thunderbikes/STM-32-Relay-Circuit/Schematic.pdf

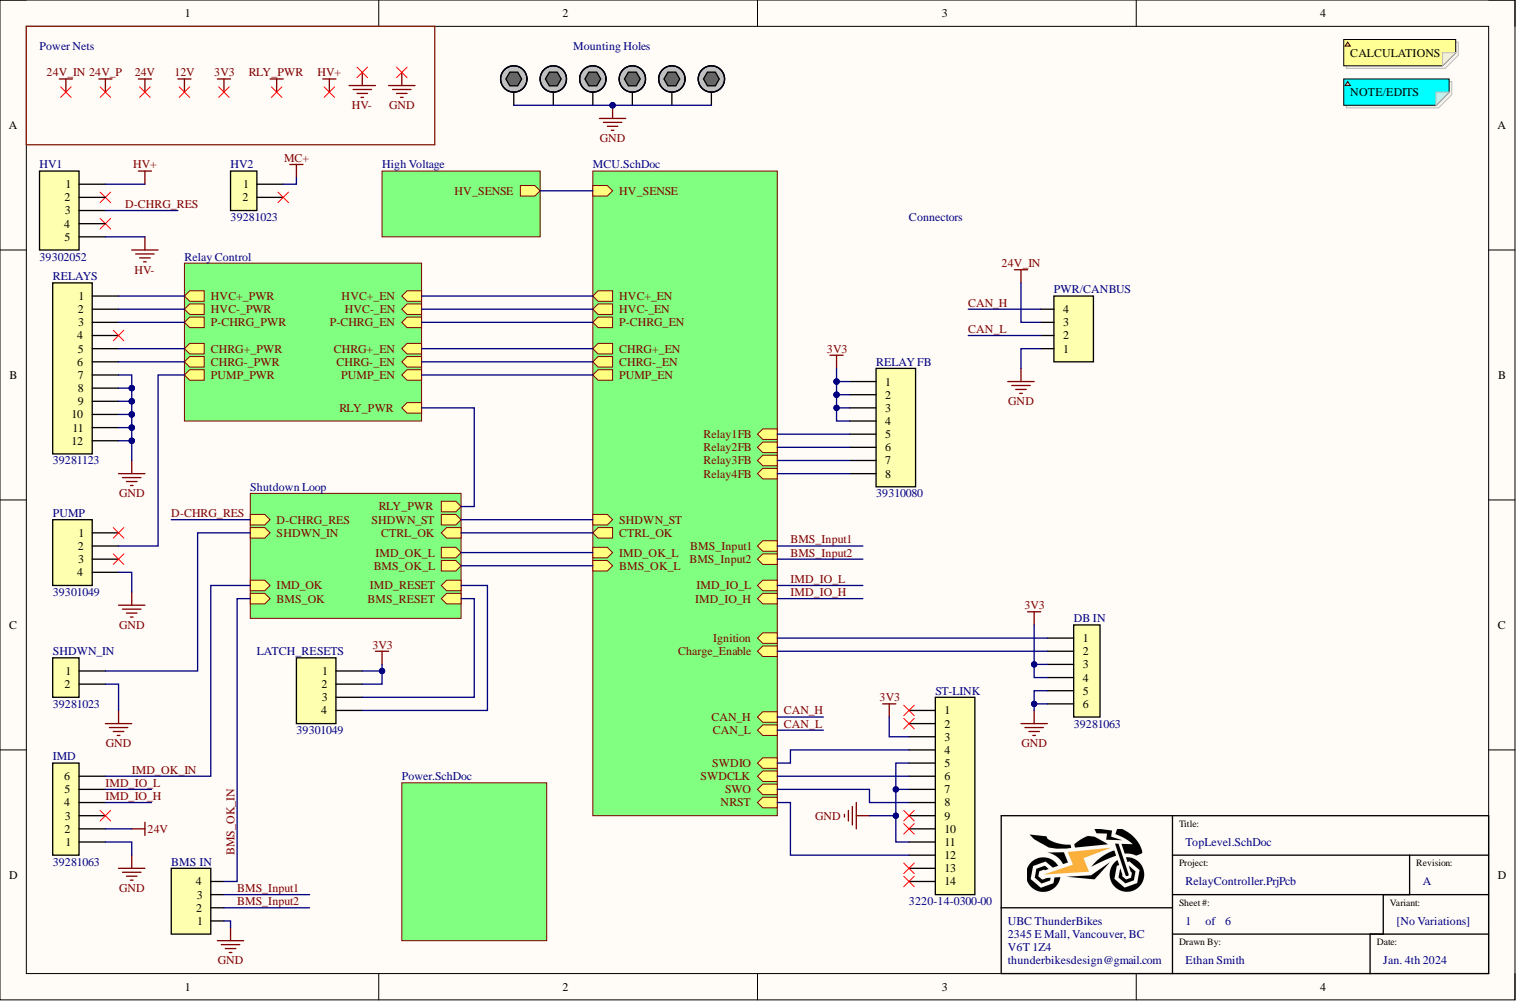
[picture p1: page 1]
Power Nets; Mounting Holes; RELAY FB; Shutdown Loop; High Voltage; Relay Control; BMS IN

IMD_OK_IN
IMD_IO_L IMD_IO_H

Title: TopLevel.SchDoc

Project: RelayController.PrjPcb | Revision: A

Sheet #: of 6 | Variant: [No Variations]

UBC ThunderBikes
2345 E Mall, Vancouver, BC
thunderbikesdesign@gmail.com

Drawn By: Ethan Smith | Date: Jan. 4th 2024

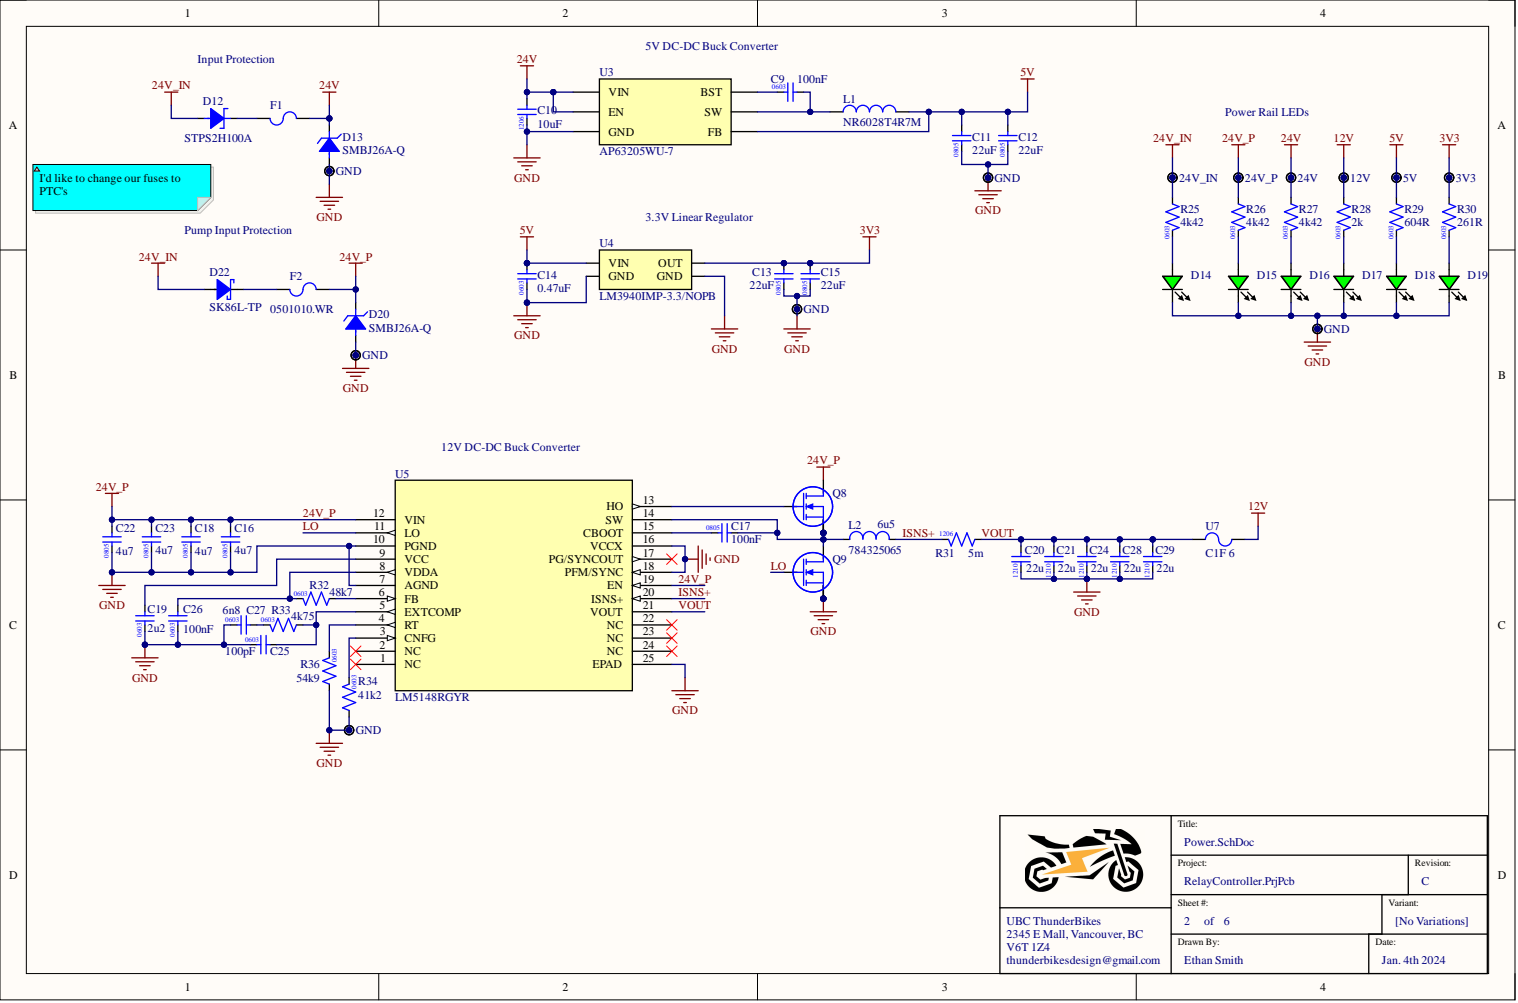
[picture p2: page 2]

5V DC-DC Buck Converter

I'd like to change our fuses to
PTC's

12V DC-DC Buck Converter

Title: Power.SchDoc

Project: RelayController.PrjPcb | Revision: C

Sheet #: | Variant:

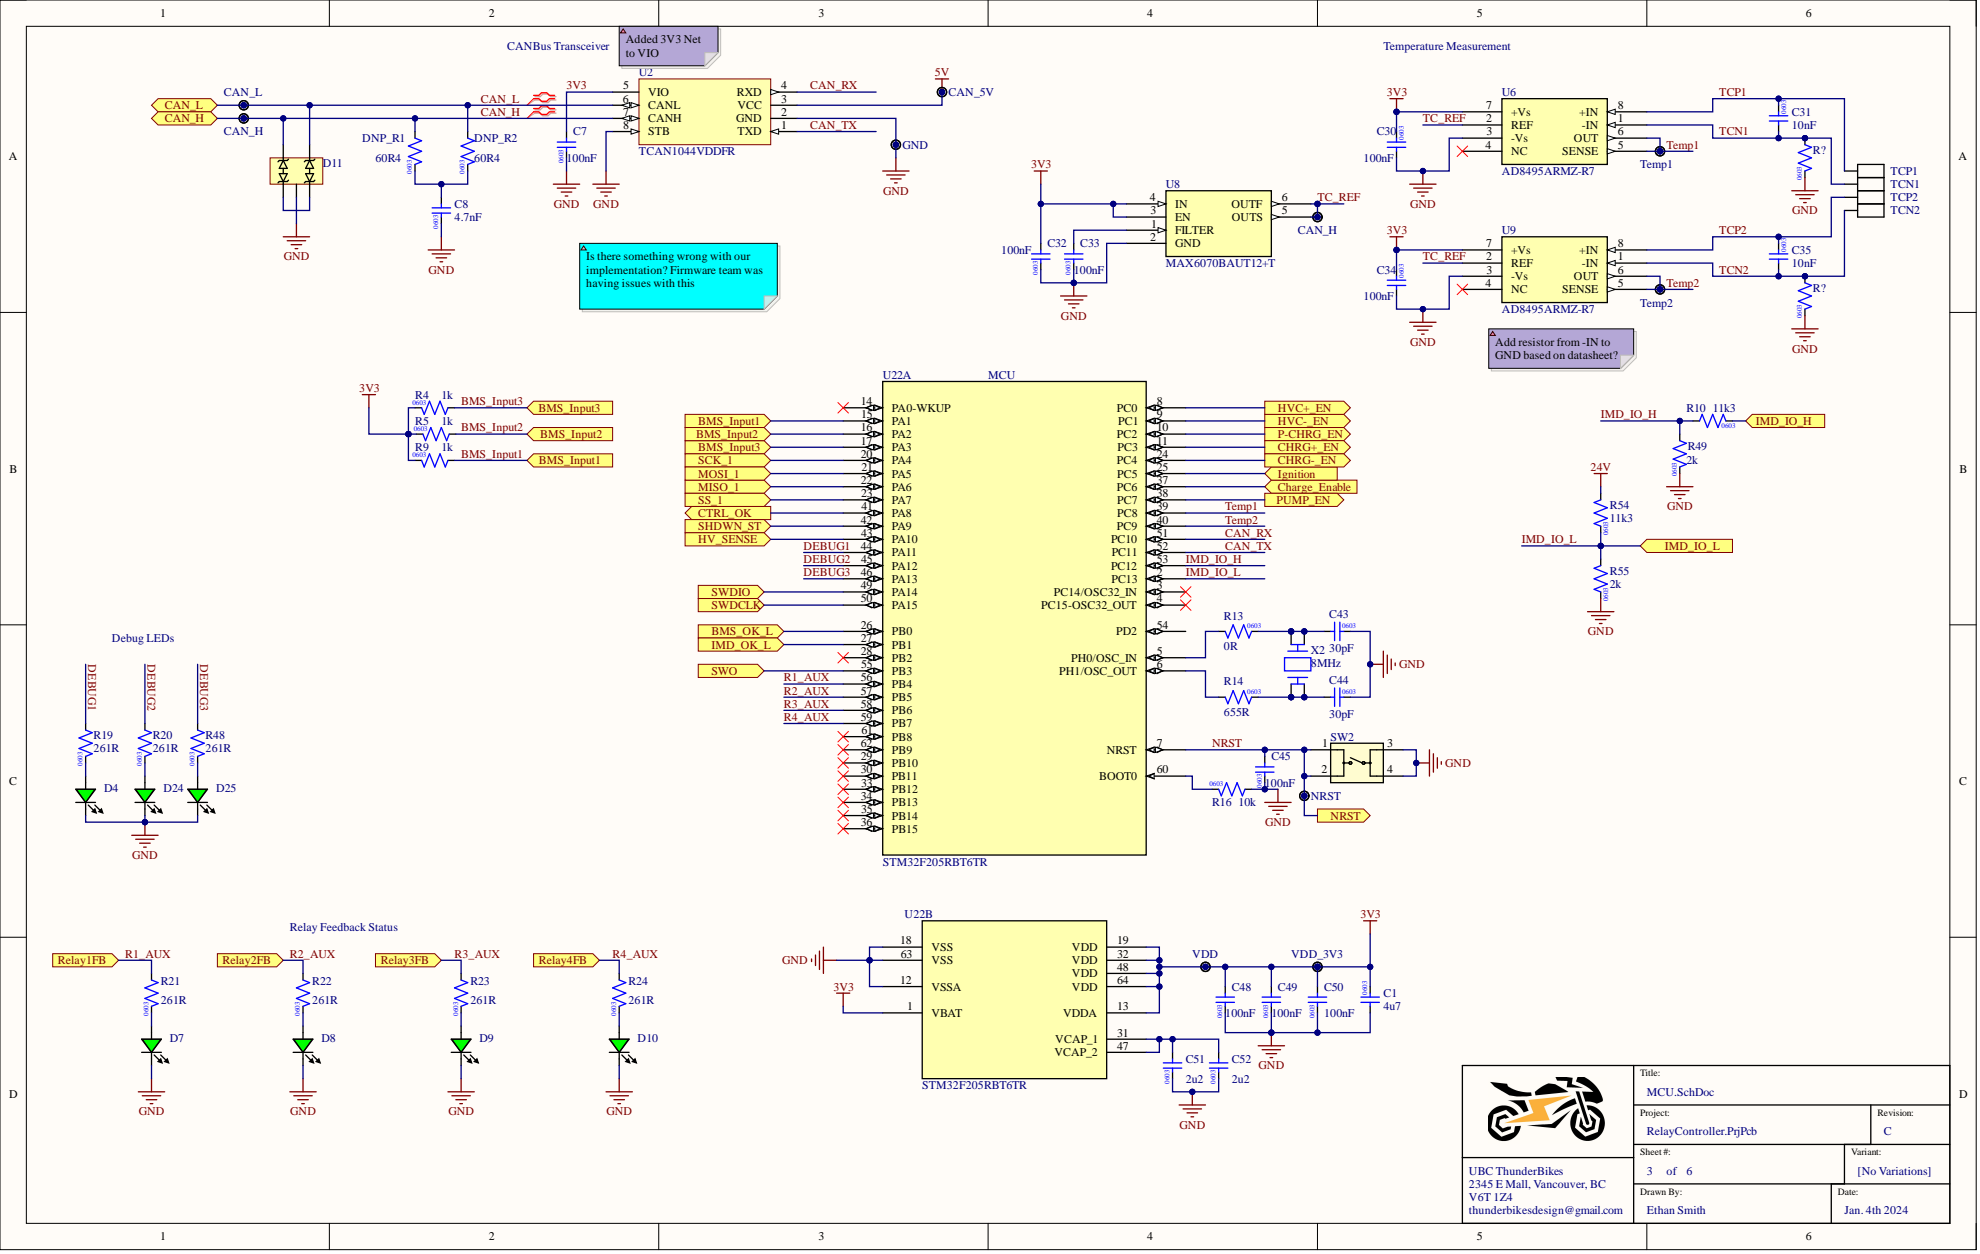
[picture p3: page 3]

-IN SENSE | 1 REF 2 | C31
-Vs 3 NC 4 | 5 OUT 6 | TCN1

CAN_TX

Temp1 | R?

Isthere something wrong with our
implementation? Firmware team was
having issues with this

-IN SENSE | 1 REF 2 | C35
-Vs 3 NC 4 | 5 OUT 6 | TCN2

Add resistor from -IN to
GND based on datasheet?

VBAT 1 | C1 3V3

Title: MCU.SchDoc

Project: RelayController.PrjPcb | Revision: C

Sheet #: | Variant:

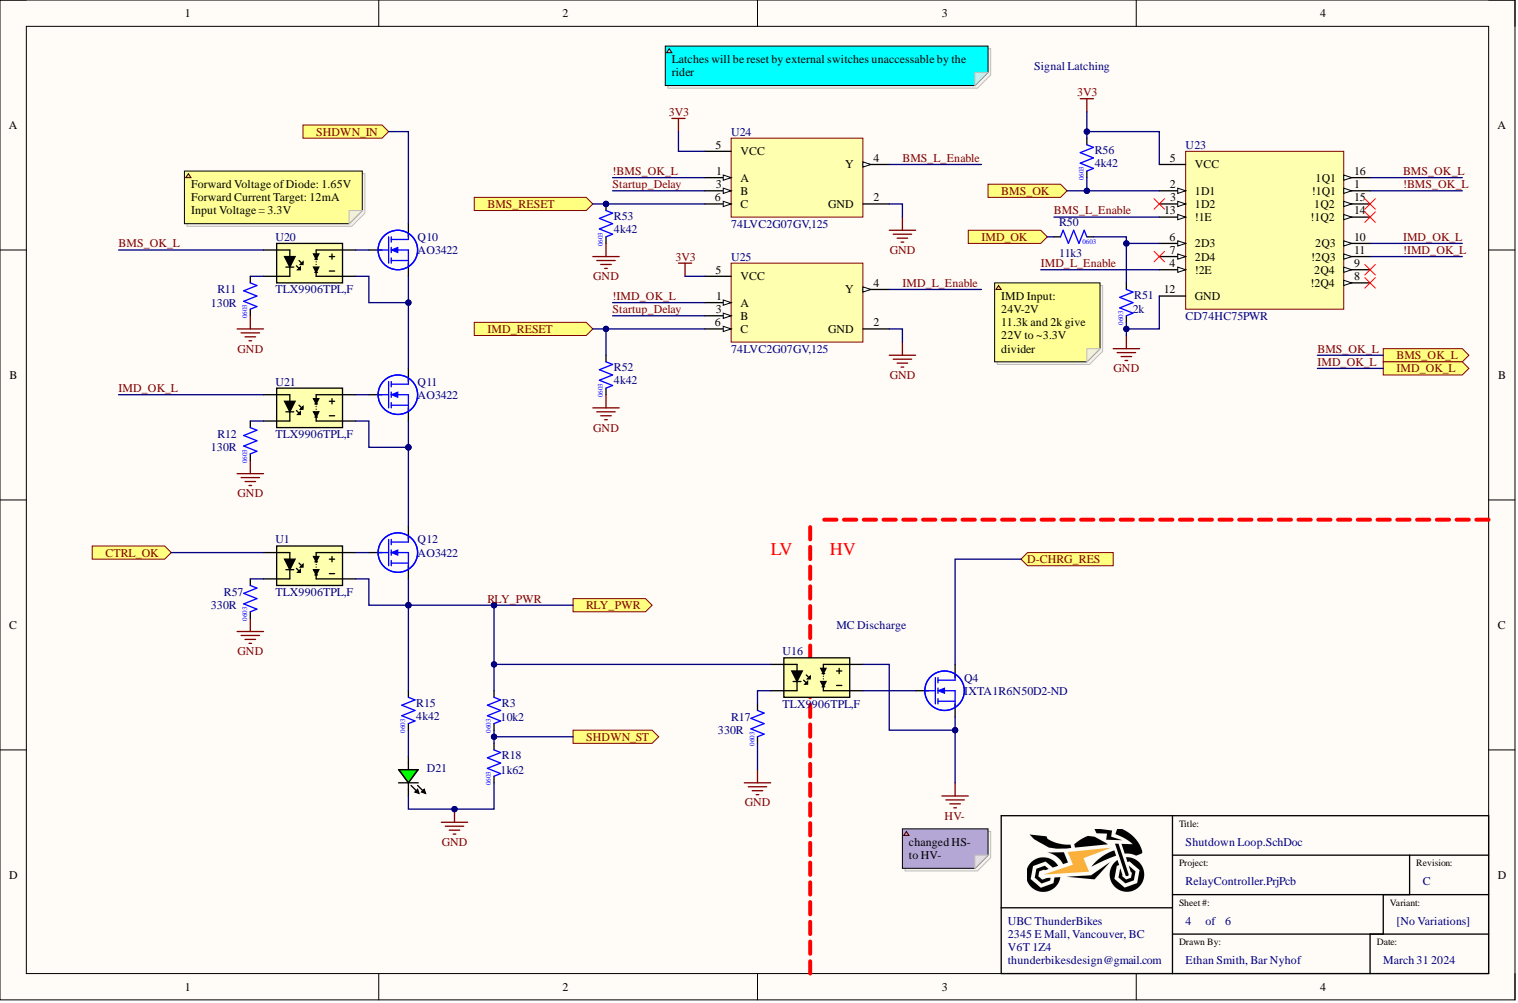
[picture p4: page 4]

Latches will be reset by externalswitches unaccessable by the
rider

Forward Voltage of Diode: 1.65V
Forward Current Target: 12mA
Input Voltage = 3.3V

Title: Shutdown Loop.SchDoc

Project: RelayController.PrjPcb | Revision: C

Sheet #: | Variant:

Ethan Smith, Bar Nyhof | March 31 2024

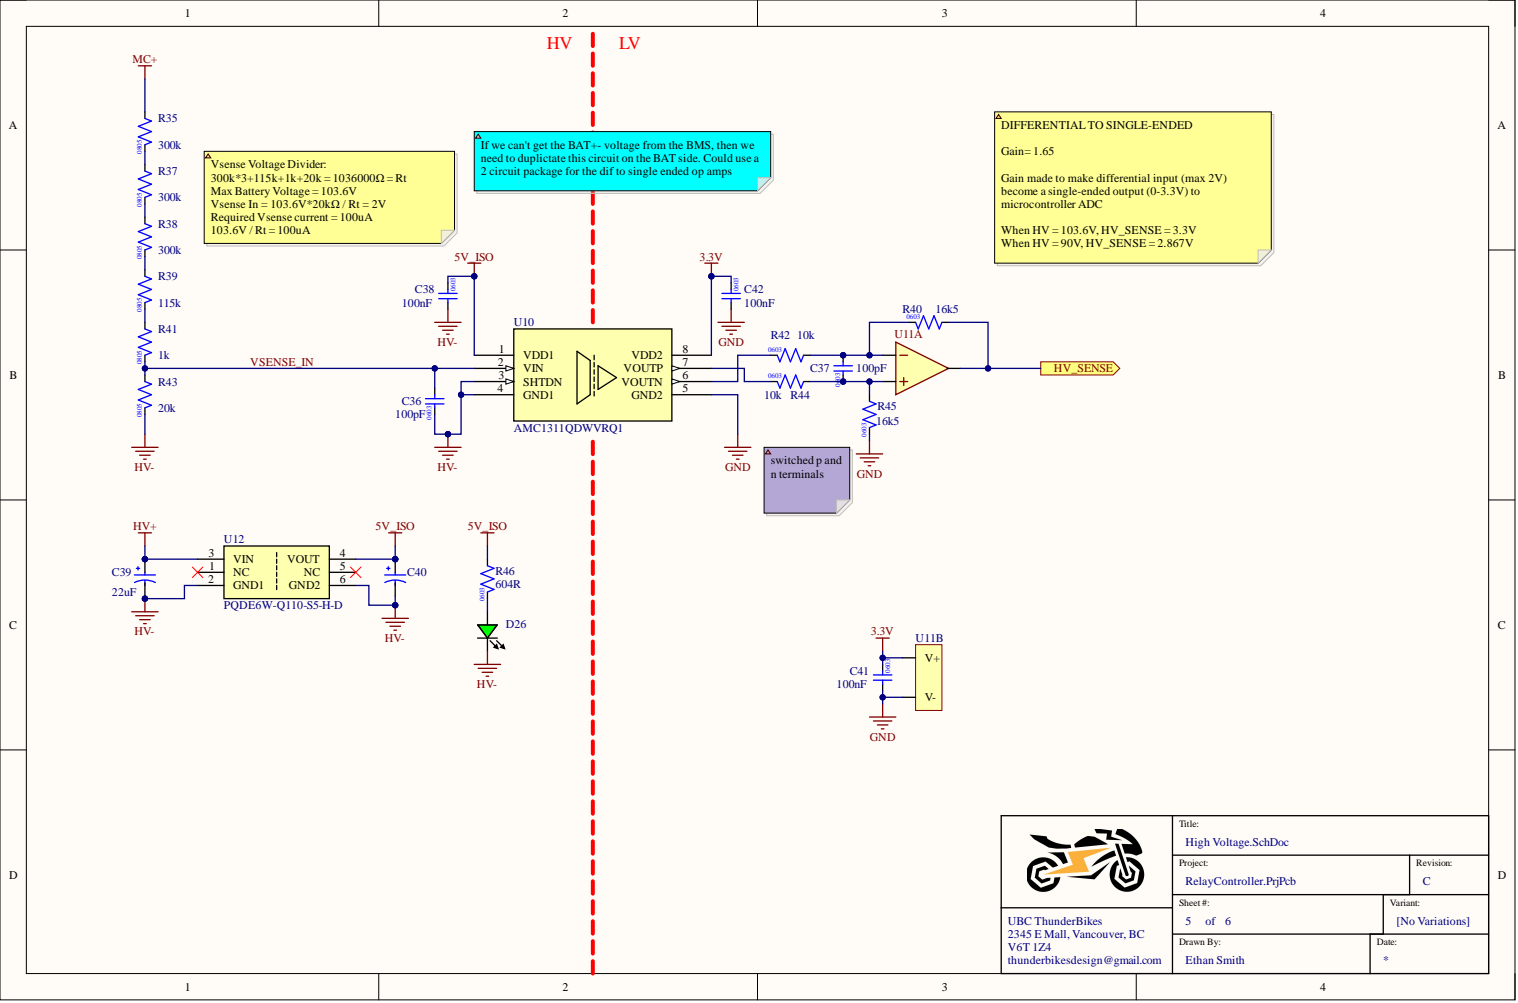
[picture p5: page 5]

If we can't get the BAT+- voltage from the BMS, then we
need to duplictate this circuit on the BAT side. Could use a

2 circuit package for the dif to single ended op amps Vsense Voltage Divider:
Max Battery Voltage = 103.6V
Vsense In = 103.6V*20kΩ / Rt = 2V
Required Vsense current = 100uA

Gain made to make differential input (max 2V)
become a single-ended output (0-3.3V) to
microcontroller ADC

Title: High Voltage.SchDoc

Project: RelayController.PrjPcb | Revision: C

Sheet #: | Variant:

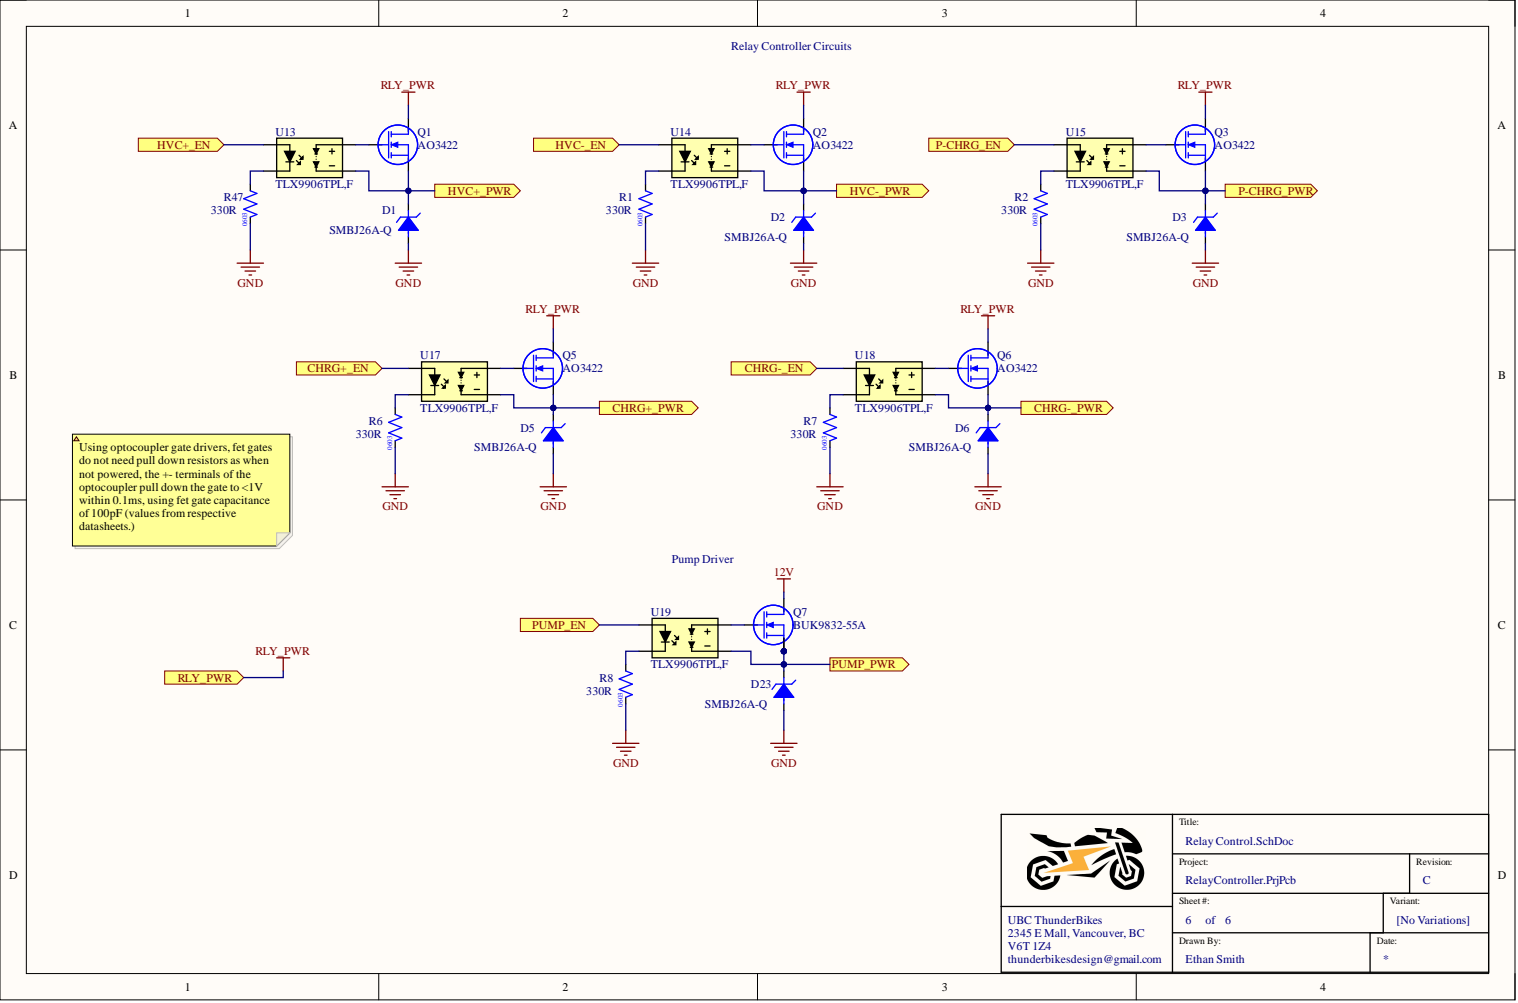
[picture p6: page 6]

Using optocoupler gate drivers, fet gates
do not need pull down resistors as when
not powered, the +- terminals of the
optocoupler pull down the gate to <1V
within 0.1ms, using fet gate capacitance
of 100pF (values from respective
datasheets.)

Title: Relay Control.SchDoc

Project: RelayController.PrjPcb | Revision: C

Sheet #: | Variant:
