thunderbikes/STM-32-Relay-Circuit/STM-32-Relay-Circuit-V2/Core/Src/main.c

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
/* Includes ------------------------------------------------------------------*/
#include "main.h"
#include <stdbool.h>
#include <stdio.h>
#include <stdlib.h>

/* USER CODE BEGIN Includes */
float Read_ADC_Voltage(void);
// watch out for running out of onboard memory because of inline
static inline void check_high(GPIO_TypeDef *GPIOx,uint16_t GPIO_Pin);
static inline void check_low(GPIO_TypeDef *GPIOx,uint16_t GPIO_Pin);

/* USER CODE END Includes */

/* USER CODE BEGIN PD */
#define HVC_POS_AUX_PORT GPIOB
#define HVC_NEG_AUX_PORT GPIOB
#define PRECHRG_AUX_PORT GPIOB
#define R4_AUX_PORT GPIOB

#define BLINK_TEST_PORT GPIOA

#define IMD_IO_H_PORT
#define IMD_IO_L_PORT

#define HVC_POS_PORT GPIOC
#define HVC_NEG_PORT GPIOC
#define PRECHRG_PORT GPIOC
#define VSENSE_OUT_PORT VSENSE_OUT_GPIO_Port
#define CHRG_POS_PORT GPIOC
#define CHRG_NEG_PORT GPIOC

#define BMS_INPUT1_PORT GPIOA
#define BMS_INPUT2_PORT GPIOA
#define BMS_INPUT3_PORT GPIOA

#define SP1_NSS_PORT
#define SP1_SCK_PORT
#define SP1_MISO_PORT
#define SP1_MOSI_PORT

#define IGNITION_PORT GPIOC
#define CHARGE_PORT GPIOC
#define PUMP_EN_PORT GPIOC

#define BMS_OUT1_PORT GPIOB
#define IMD_IO_H_PORT GPIOB
#define SAFETY_LOOP_ST_PORT GPIOA

#define CAN1_TX_PORT
#define CAN1_RX_PORT

typedef enum {
	UPDATING, SHUTDOWN, STANDBY, CHARGING, PRECHARGE, OPERATION, DISCHARGE
} AllStatus;

AllStatus Status = STANDBY;
int updating_counter = 0;
int operation = 0;
int ignition = 0;
int charging = 0;

float can_voltage =0.0;

uint32_t updating_start_tick = 0;
/* USER CODE END PD */

ADC_HandleTypeDef hadc1;

SPI_HandleTypeDef hspi1;

TIM_HandleTypeDef htim2;
TIM_HandleTypeDef htim13;

void SystemClock_Config(void);
static void MX_GPIO_Init(void);
static void MX_ADC1_Init(void);
static void MX_SPI1_Init(void);
static void MX_TIM13_Init(void);
static void MX_TIM2_Init(void);
/* USER CODE BEGIN PFP */
void while_operation(void);
void set_discharge(void);
void set_precharge(void);  // Forward declaration
void set_charging(void);   // Forward declaration
/* USER CODE END PFP */

/* USER CODE BEGIN 0 */
void allRelaysOpen() {
	HAL_GPIO_WritePin(HVC_POS_PORT, HVC_POS_Pin, GPIO_PIN_RESET); // AUX_1
	HAL_GPIO_WritePin(HVC_NEG_PORT, HVC_NEG_Pin, GPIO_PIN_RESET); // AUX_2
	HAL_GPIO_WritePin(PRECHRG_PORT, PRECHRG_Pin, GPIO_PIN_RESET); // AUX_3

	HAL_GPIO_WritePin(CHRG_NEG_PORT, CHRG_NEG_Pin, GPIO_PIN_RESET);
	HAL_GPIO_WritePin(CHRG_POS_PORT, CHRG_POS_Pin, GPIO_PIN_RESET);
	HAL_GPIO_WritePin(PUMP_EN_PORT, PUMP_EN_Pin, GPIO_PIN_RESET);

	HAL_Delay(1000);

	check_low(HVC_POS_AUX_PORT, HVC_POS_AUX_Pin);
	check_low(HVC_NEG_AUX_PORT, HVC_NEG_AUX_Pin);
	check_low(PRECHRG_AUX_PORT, PRECHRG_AUX_Pin);

}

void allDigitalRead() {
	HAL_GPIO_ReadPin(IGNITION_PORT, IGNITION_Pin);
	HAL_GPIO_ReadPin(CHARGE_PORT, CHARGE_Pin);

}

void allAuxDigitalRead() {
	HAL_GPIO_ReadPin(HVC_POS_AUX_PORT, HVC_POS_AUX_Pin);
	HAL_GPIO_ReadPin(HVC_NEG_AUX_PORT, HVC_NEG_AUX_Pin);
	HAL_GPIO_ReadPin(PRECHRG_AUX_PORT, PRECHRG_AUX_Pin);
}

int Reading_Pin(char aux_number) {
	int state = 0; // Default state
	switch (aux_number) {
	case '1':
		state = HAL_GPIO_ReadPin(HVC_POS_AUX_PORT, HVC_POS_AUX_Pin);
		break;
	case '2':
		state = HAL_GPIO_ReadPin(HVC_NEG_AUX_PORT, HVC_NEG_AUX_Pin);
		break;
	case '3':
		state = HAL_GPIO_ReadPin(PRECHRG_AUX_PORT, PRECHRG_AUX_Pin);
		break;
	case 'I':
		state = HAL_GPIO_ReadPin(IGNITION_PORT, IGNITION_Pin);
		break;
	case 'c':
		state = HAL_GPIO_ReadPin(CHARGE_PORT, CHARGE_Pin);
		break;
	case 'h':
		state = HAL_GPIO_ReadPin(VSENSE_OUT_GPIO_Port, VSENSE_OUT_Pin);
		break;
	default:
		state = -1; // Indicate an invalid aux_number
		break;
	}
	return state;
}
/* USER CODE END 0 */

/**
  * @brief  The application entry point.
  * @retval int
  */
int main(void)
{

  /* MCU Configuration--------------------------------------------------------*/

  /* Reset of all peripherals, Initializes the Flash interface and the Systick. */
  HAL_Init();

  /* Configure the system clock */
  SystemClock_Config();

  /* Initialize all configured peripherals */
  MX_GPIO_Init();
  MX_ADC1_Init();
  MX_SPI1_Init();
  MX_TIM13_Init();
  MX_TIM2_Init();
  /* Infinite loop */
  /* USER CODE BEGIN WHILE */
  while (1)
  {
    /* USER CODE END WHILE */

	  if (HAL_GPIO_ReadPin(IGNITION_PORT, IGNITION_Pin) == GPIO_PIN_SET) {
		  set_precharge();
	  	  while_operation();
	  }

	  else if (HAL_GPIO_ReadPin(CHARGE_PORT, CHARGE_Pin) == GPIO_PIN_SET) {
	  	  set_charging();
  	  }

    /* USER CODE BEGIN 3 */
  }
  /* USER CODE END 3 */
}

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
/* USER CODE BEGIN 4 */
int _write(int file, char *ptr, int len) {
	(void) file;
	int DataIdx;

	for (DataIdx = 0; DataIdx < len; DataIdx++) {
		ITM_SendChar(*ptr++);
	}
	return len;
}


void HAL_TIM_PeriodElapsedCallback(TIM_HandleTypeDef *htim) {
// Check if the interrupt comes from TIM2


	if(htim->Instance == TIM3){
		can_voltage = 103.6; 	// MANUAL SET VOLTAGE
		}
	if (htim->Instance == TIM2) {
		if (HAL_GPIO_ReadPin(SAFETY_LOOP_ST_PORT, SAFETY_LOOP_ST_Pin) == GPIO_PIN_SET) {
			Status = SHUTDOWN;
		}

		switch (Status) {
		case UPDATING:
			if (updating_start_tick == 0) { // Initialize start tick on first entry
				updating_start_tick = HAL_GetTick();
			}
				// Check if 30 seconds have elapsed
			if ((HAL_GetTick() - updating_start_tick) > 30000) {
				updating_start_tick = 0;  // Reset for next use
				Error_Handler();
			}
			break;
		case SHUTDOWN:
			if (HAL_GPIO_ReadPin(IMD_IO_H_PORT, IMD_IO_H_Pin)
					== GPIO_PIN_RESET) {
				printf("IMD NOT OK.\n");
			} else if (HAL_GPIO_ReadPin(BMS_OUT1_PORT, BMS_OUT1_Pin)
					== GPIO_PIN_RESET) {
				printf("BMS NOT OK.\n");
			} else {
				printf("Cause of shutdown is unknown.\n");
			}
			Error_Handler();
		case STANDBY:
			//i forgot which AUX pins we need to check for standby -ray
			if (HAL_GPIO_ReadPin(HVC_POS_AUX_PORT, HVC_POS_AUX_Pin) == GPIO_PIN_RESET) { //please double check all AUX pins -ray
				if (HAL_GPIO_ReadPin(HVC_NEG_AUX_PORT, HVC_NEG_AUX_Pin)
						== GPIO_PIN_RESET) { //also 3 if statements seems a bit more readable
					if (HAL_GPIO_ReadPin(PRECHRG_AUX_PORT, PRECHRG_AUX_Pin)
							== GPIO_PIN_RESET) {
						break;
					}
				}
			}
			Error_Handler();
		case CHARGING:
			//i dont know which AUX pins we need to check for charging -ray
			if (HAL_GPIO_ReadPin(HVC_POS_AUX_PORT, HVC_POS_AUX_Pin) == GPIO_PIN_RESET) { //please double check all AUX pins -ray
				if (HAL_GPIO_ReadPin(HVC_NEG_AUX_PORT, HVC_NEG_AUX_Pin)
						== GPIO_PIN_RESET) { //also 3 if statements seems a bit more readable
					if (HAL_GPIO_ReadPin(PRECHRG_AUX_PORT, PRECHRG_AUX_Pin)
							== GPIO_PIN_RESET) {
						break;
					}
				}
			}
			Error_Handler();
		case PRECHARGE:
			if (HAL_GPIO_ReadPin(HVC_POS_AUX_PORT, HVC_POS_AUX_Pin) == GPIO_PIN_RESET) { //please double check all AUX pins -ray
				if (HAL_GPIO_ReadPin(HVC_NEG_AUX_PORT, HVC_NEG_AUX_Pin) == GPIO_PIN_SET) { //also 3 if statements seems a bit more readable
					if (HAL_GPIO_ReadPin(PRECHRG_AUX_PORT, PRECHRG_AUX_Pin)
							== GPIO_PIN_SET) {
						break;
					}
				}
			}
			Error_Handler();
		case OPERATION:
			if (HAL_GPIO_ReadPin(HVC_POS_AUX_PORT, HVC_POS_AUX_Pin) == GPIO_PIN_SET) {
				if (HAL_GPIO_ReadPin(HVC_NEG_AUX_PORT, HVC_NEG_AUX_Pin) == GPIO_PIN_SET) {
					if (HAL_GPIO_ReadPin(PRECHRG_AUX_PORT, PRECHRG_AUX_Pin)
							== GPIO_PIN_RESET) {
						break;
					}
				}
			}
			Error_Handler();
		case DISCHARGE:
			if (HAL_GPIO_ReadPin(HVC_POS_AUX_PORT, HVC_POS_AUX_Pin) == GPIO_PIN_RESET) {
				if (HAL_GPIO_ReadPin(HVC_NEG_AUX_PORT, PRECHRG_AUX_Pin)
						== GPIO_PIN_RESET) {
					if (HAL_GPIO_ReadPin(PRECHRG_AUX_PORT, PRECHRG_AUX_Pin)
							== GPIO_PIN_RESET) {
						break;
					}
				}
			}
			Error_Handler();
		default:
			Error_Handler();
		}
	}
}

// delays are now built into the checks -ray
static inline void check_high(GPIO_TypeDef *GPIOx,uint16_t GPIO_Pin){ //
	for (int i = 0; i < 5; ++i) {
		HAL_Delay(100);
        	if (HAL_GPIO_ReadPin(GPIOx, GPIO_Pin)) {
			return;
		}
	}
	Error_Handler();
}

static inline void check_low(GPIO_TypeDef *GPIOx, uint16_t GPIO_Pin) {
    for (int i = 0; i < 5; ++i) {
        HAL_Delay(100);
        if (!HAL_GPIO_ReadPin(GPIOx, GPIO_Pin)) {
            return;
        }
    }
    Error_Handler(); // Trigger error handler if the pin state is not low after retries
}


//these functions use mostly copied code from old main loop -ray
void set_precharge() {
	uint32_t start_tick = HAL_GetTick(); // in milliseconds
	uint32_t timeout = 30000; // Timeout set for 30000 milliseconds or 30 seconds
	double hv_sense_voltage;
	bool voltage_reached = false;

	Status = UPDATING;
	allRelaysOpen();
	HAL_GPIO_WritePin(HVC_NEG_PORT, HVC_NEG_Pin, GPIO_PIN_SET);
	check_high(HVC_NEG_AUX_PORT, HVC_NEG_AUX_Pin);
	HAL_GPIO_WritePin(PRECHRG_PORT, PRECHRG_Pin, GPIO_PIN_SET);
	check_high(PRECHRG_AUX_PORT, PRECHRG_AUX_Pin);

	while (1) {
		hv_sense_voltage = Read_ADC_Voltage();
		if (hv_sense_voltage >= 0.9 * can_voltage) { // CANBUS VLAUE FROM ISR
			voltage_reached = true;
			Status = PRECHARGE; // Successfully precharged, update status
			while_operation();
			break; // Exit the loop on successful precharge
		}

		// Check for timeout
		if (HAL_GetTick() - start_tick >= timeout) {
			break; // Exit the loop after timeout
		}

		HAL_Delay(1000); // Delay for 1 second before checking again
	}

	if (!voltage_reached) {
		printf("Failed to reach the required voltage within 30 seconds.\n");
		Error_Handler(); // Handle the timeout error
	}
	return;
}

void while_operation() {
	if (HAL_GPIO_ReadPin(IGNITION_PORT, IGNITION_Pin) == GPIO_PIN_RESET) {
		set_discharge();
	} else {
		Status = UPDATING;
		HAL_GPIO_WritePin(HVC_POS_PORT, HVC_POS_Pin, GPIO_PIN_SET);
		check_high(HVC_POS_AUX_PORT, HVC_POS_AUX_Pin);

		HAL_Delay(1000); // Wait for 1 second to ensure stability

		HAL_GPIO_WritePin(PRECHRG_PORT, PRECHRG_Pin, GPIO_PIN_RESET);
		check_low(PRECHRG_AUX_PORT, PRECHRG_AUX_Pin);

		Status = OPERATION; // Set status to OPERATION
	}
	return;
}

void set_discharge() {
	Status = UPDATING;
	HAL_Delay(30000); // 30-second delay for any necessary pre-discharge preparations

	allRelaysOpen(); // Open all relays to ensure system is in a safe state before discharging

	HAL_GPIO_WritePin(MCU_OK_GPIO_Port, MCU_OK_Pin, GPIO_PIN_RESET);

	operation = 0; // Reset operation status
	Status = DISCHARGE; // Set status to DISCHARGE
	return;
}

void set_charging() {
	Status = UPDATING;
	allRelaysOpen();  // Open all relays to ensure the system is in a safe state

	HAL_GPIO_WritePin(CHRG_NEG_PORT, CHRG_NEG_Pin, GPIO_PIN_SET);

	HAL_GPIO_WritePin(CHRG_POS_PORT, CHRG_POS_Pin, GPIO_PIN_SET);

	Status = CHARGING; // Update system status to CHARGING after successful pin settings
}

float Read_ADC_Voltage(void) {
	uint32_t hv_sense_value;
	// Start the ADC
	HAL_ADC_Start(&hadc1);

	// Poll for conversion completion with a timeout of 10ms
	if (HAL_ADC_PollForConversion(&hadc1, 100) == HAL_OK) {
		hv_sense_value = HAL_ADC_GetValue(&hadc1);
		return (hv_sense_value / 4095.0) * 103.6;
	} else {
		// Handle the error or return a default value
		return -1.0f;  // Indicate an error in conversion
	}
}
/* USER CODE END 4 */
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
