thunderbikes/STM-32-Relay-Circuit/STM-32-Relay-Circuit-V2/Core/Inc/main.h

#define HVC_NEG_Pin GPIO_PIN_0
#define HVC_NEG_GPIO_Port GPIOC
#define HVC_POS_Pin GPIO_PIN_1
#define HVC_POS_GPIO_Port GPIOC
#define CHRG_POS_Pin GPIO_PIN_2
#define CHRG_POS_GPIO_Port GPIOC
#define CHRG_NEG_Pin GPIO_PIN_3
#define CHRG_NEG_GPIO_Port GPIOC
#define VSENSE_OUT_Pin GPIO_PIN_0
#define VSENSE_OUT_GPIO_Port GPIOA
#define BMS_OUT1_Pin GPIO_PIN_1
#define BMS_OUT1_GPIO_Port GPIOA
#define BMS_OUT2_Pin GPIO_PIN_2
#define BMS_OUT2_GPIO_Port GPIOA
#define BMS_OUT3_Pin GPIO_PIN_3
#define BMS_OUT3_GPIO_Port GPIOA
#define PRECHRG_Pin GPIO_PIN_4
#define PRECHRG_GPIO_Port GPIOC
#define IGNITION_Pin GPIO_PIN_5
#define IGNITION_GPIO_Port GPIOC
#define CHARGE_Pin GPIO_PIN_0
#define CHARGE_GPIO_Port GPIOB
#define DEBUG_1_Pin GPIO_PIN_1
#define DEBUG_1_GPIO_Port GPIOB
#define DEBUG_2_Pin GPIO_PIN_2
#define DEBUG_2_GPIO_Port GPIOB
#define PUMP_EN_Pin GPIO_PIN_7
#define PUMP_EN_GPIO_Port GPIOC
#define TEMP_A_Pin GPIO_PIN_8
#define TEMP_A_GPIO_Port GPIOC
#define MCU_OK_Pin GPIO_PIN_8
#define MCU_OK_GPIO_Port GPIOA
#define SAFETY_LOOP_ST_Pin GPIO_PIN_9
#define SAFETY_LOOP_ST_GPIO_Port GPIOA
#define SWDIO_Pin GPIO_PIN_13
#define SWDIO_GPIO_Port GPIOA
#define SWDCLK_Pin GPIO_PIN_14
#define SWDCLK_GPIO_Port GPIOA
#define SWO_Pin GPIO_PIN_3
#define SWO_GPIO_Port GPIOB
#define HVC_POS_AUX_Pin GPIO_PIN_4
#define HVC_POS_AUX_GPIO_Port GPIOB
#define HVC_NEG_AUX_Pin GPIO_PIN_5
#define HVC_NEG_AUX_GPIO_Port GPIOB
#define PRECHRG_AUX_Pin GPIO_PIN_6
#define PRECHRG_AUX_GPIO_Port GPIOB
#define IMD_IO_H_Pin GPIO_PIN_7
#define IMD_IO_H_GPIO_Port GPIOB
