thunderbikes/STM-32-Relay-Circuit/(commit log)

2023-11-18 Added STM32CubeMX Project
2023-11-18 Uploaded updated relaycontroller.ioc
    Updated relaycontrolelr.ioc file with the inclusion of bms pins and switch inputs as GPIO pins
2023-11-26 Updated ioc file
    Included bms inputs as well as pump inputs leaving 2 spare pins on the board
2023-12-02 updated kimathras code
    Fixed few errors, add auxillary logic with delay and successfully complies
    [main.c]
2023-12-02 updated main.c to include bms relays
    improved logic with old bms relays implemented
2024-05-23 Updated main.c and other files with new pin configs
2024-05-23 Added analog pin
2024-05-25 updated gpio pins with adc
2024-05-26 interupt, state functions and error handling
    [main.c]
2024-06-01 Added tim3 ISR for canbus voltage
2024-06-01 Massive changes to main.c check desc
    - added pin low verification and aux checks within allRelaysOpen()
    - removed check_and_handle_pins()
    - added check_low() and check_high() -> see comments for details
    - defined both previous functions and replaced all check_handle_pins()
    [main.c]
2024-06-01 Updated relay functions to check pins using check_high and check_low
2024-06-22 Delete MOSFET Control/MOSFET Control.ioc
    Deleting old mosfet ioc
