thunderbikes/STM-32-Relay-Circuit/(notices)

Notices in the files:
STM-32-Relay-Circuit-V2/Core/Src/main.c:
Copyright (c) 2024 STMicroelectronics.
All rights reserved.
This software is licensed under terms that can be found in the LICENSE file
